octoprobe/testbed_tutorial/README.rst

Testbed `testbed_showcase`
==========================

`Documentation <http://www.octoprobe.org/testbed_showcase>`_
