octoprobe/testbed_tutorial/docs/testbed_showcase/40_specification/40_tentacles/index.rst

Tentacles
=========

:download:`Schematics </../schematics_kicad/schematics.pdf>`

.. toctree::
   :glob:
   :maxdepth: 2

   */*
