octoprobe/testbed_tutorial/docs/testbed_showcase/40_specification/40_tentacles/MCU_LOLIN_D1_MINI/index.rst

Tentacle `MCU_LOLIN_D1_MINI`
============================

Supported FUTs: FUT_EXTMOD_HARDWARE

v0.1 FUT_EXTMOD_HARDWARE

:download:`Schematics </../schematics_kicad/schematics.pdf>`



* `Pinout LOLIN_D1_MINI <https://www.wemos.cc/en/latest/_images/d1_mini_v4.0.0_5_16x9.png>`_
* `Datasheet ESP8266EX <https://www.espressif.com/sites/default/files/documentation/0a-esp8266ex_datasheet_en.pdf>`_

Pins assignements
-----------------

BOOTSEL is NOT required

====  =======  ========  ===================
CPU   Pin      signals   rationale
====  =======  ========  ===================
\     GND                GND
D1    5        RX        FUT_EXTMOD_HARDWARE
D2    4        TX        FUT_EXTMOD_HARDWARE
====  =======  ========  ===================
