octoprobe/testbed_tutorial/docs/testbed_showcase/40_specification/40_tentacles/DEVICE_potpourri/index.rst

Tentacle `DEVICE_POTPOURRY`
===========================

:download:`Schematics </../schematics_kicad/schematics.pdf>`

This tentacle comines many features, thus `potpourry`.

FUT implemented
---------------

* I2C

  The eeprom may be read and write.

* Onewire

  The MCU may read out the serial number of the two DS18b temperature sensors.

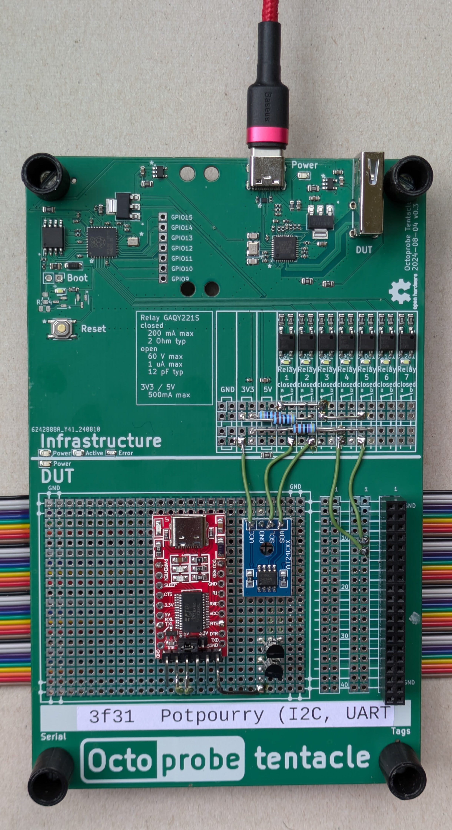
[picture p6: docs/testbed_showcase/40_specification/40_tentacles/DEVICE_potpourri/top_view.jpg]
