octoprobe/testbed_tutorial/docs/introduction/50_flightlevel_hardware.rst

Flightlevel: hardware
==============================================================================================

The hardware of `testbed_showcase` is described in :doc:`/testbed_showcase/index`.

.. rubric:: Block diagram

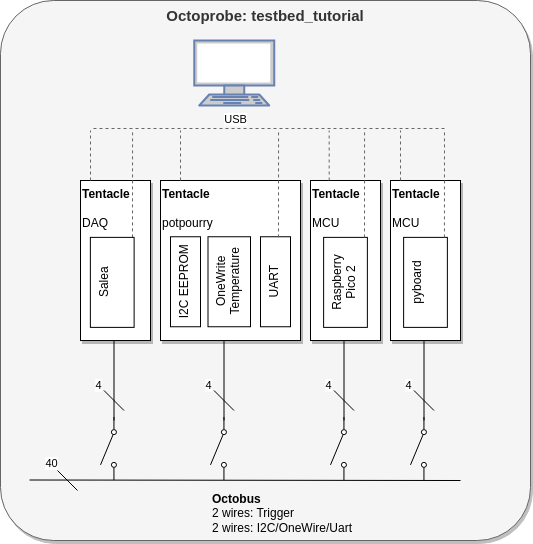
[picture p7: docs/testbed_showcase/20_designing_a_testbed/block_diagram.drawio.png]
