octoprobe/testbed_tutorial/docs/testbed_showcase/40_specification/20_tentacle-roles.rst

Tentacle roles
==============

The `TENTACLE_MCU` has to specify a processor and the intended firmware variants.

===========================  ==================================
Tentacle role                Comment 
===========================  ==================================
`TENTACLE_MCU`               A microprocessor tentacle 
`TENTACLE_DEVICE_POTPOURRY`  A tentacle with several devices 
`TENTACLE_DAQ_SALEAE`        Dataaquisition and error provoking 
===========================  ==================================
