octoprobe/testbed_tutorial/docs/installation/ubuntu.rst

Installation Ubuntu
===================

Target OS: Ubuntu Server 24.04.1 LTS.

To set up a Raspberry Pi 4/5, start with :doc:`/installation/raspberry`.

Installation: Users
-------------------

Octoprobe user: `octoprobe`
Github runner user: `githubrunner`

Do not forget to config git:

.. code::

    git config --global user.name "Hans Maerki"
    git config --global user.email "buhtig.hans.maerki@ergoinfo.ch"

Installation: APT
-----------------

.. code::

    sudo apt update \
      && sudo apt upgrade -y \
      && sudo apt install -y git uhubctl dfu-util \
        python-is-python3 python3.12-venv \
        docker.io docker-buildx

    sudo groupadd docker
    sudo usermod -aG docker $USER

On Raspbian: Skip python3.12-venv

## git clone testbed_tutorial

.. code::

    git clone https://github.com/octoprobe/testbed_tutorial.git

## python

.. code::

    echo 'source ~/venv_octoprobe/bin/activate' >> ~/.profile
    # Log out and in again
    python -m venv ~/venv_octoprobe

    source ~/venv_octoprobe/bin/activate
    pip install --upgrade -r ~/testbed_tutorial/requirements.txt -r ~/testbed_tutorial/requirements_dev.txt

## Software requiring root access

Will be used by mpremote and others

.. code::

    sudo usermod -a -G dialout $USER

APT

.. code::

    op install

Now `op install` will instruct you to:

.. code::

    sudo chown root:root ~/octoprobe_downloads/binaries/aarch64/*
    sudo chmod a+s ~/octoprobe_downloads/binaries/aarch64/*
    sudo cp -p ~/octoprobe_downloads/binaries/aarch64/* /usr/sbin

Run your first tests
--------------------

Add to :code:`~/.profile`:

.. code::

    export OCTOPROBE_TESTBED=testbed_ch_wetzikon_1.py

Verify if the tentacle serial numbers in above :code:`testbed_ch_wetzikon_1.py` match with the tentacle connected via USB.

Start the tests

.. code:: 

   cd ~/testbed_tutorial
   pytest --firmware-json=pytest_args_firmware_RPI_PICO2_v1.24.0.json tests/test_simple.py::test_i2c
