octoprobe/testbed_tutorial/docs/testbed_showcase/index.rst

Testbed `testbed_showcase`
==========================

.. toctree::
   :glob:
   :maxdepth: 2

   */**
