octoprobe/testbed_tutorial/docs/sandbox/experiment_autodoc.rst

Reference a function:

.. autofunction:: tests.conftest::setup_tentacles
    :no-index:

Reference a function. Do only describe some parameters:

.. autofunction:: tests.conftest::setup_tentacles(active_tentacles)
    :no-index:

Reference to a class

.. autoclass:: testbed.util_firmware_mpbuild::CachedGitRepo()
    :no-index:

Reference to a method

.. automethod:: testbed.util_firmware_mpbuild::build_firmware()
    :no-index:

Reference to a property

.. autoproperty:: octoprobe.util_dut_programmers::FirmwareDownloadSpec.filename()
    :no-index:
