octoprobe/testbed_tutorial/docs/sandbox/experiment_section_1.rst

.. Restructured text comment: IGNORE_SECTION_CHECK

Flightlevel: github
===================

SubSection A
----------------------------------------------------------------------------------------------

SubSubSection A
^^^^^^^^^^^^^^^^^^^^^^^^

Blabla

SubSection B
----------------------------------------------------------------------------------------------

Blabla

SubSubSubSection B1
~~~~~~~~~~~~~~~~~~~~~~~~~~~~~~~~~~~~~~~~~~~~~~~~~~~~~~~~~~~~~~~~~~~~

.. note::

   SubSubSubSection B1

   has been swallowed as ``SubSubSubSection``

SubSubSection B2
^^^^^^^^^^^^^^^^^^^^^^^^^^^^^^^^^

SubSubSubSection B2
~~~~~~~~~~~~~~~~~~~~~~~~~~~~~~~~~~~~~~~~~~~~~~~~~~~~~~~~~~~~~~~~~~~~

.. note::

   SubSubSubSection B2

   has been swallowed!!!

Blabla

SubSection C
----------------------------------------------------------------------------------------------

Blabla C

SubSubSubSection C3
~~~~~~~~~~~~~~~~~~~~~~~~~~~~~~~~~~~~~~~~~~~~~~~~~~~~~~~~~~~~~~~~~~~~

.. note::

   SubSubSubSection: C3

   has been swallowed!!!

Blabla C3

SubSection D
----------------------------------------------------------------------------------------------

Blabla D

.. note::

   SubSubSubSection: X
