octoprobe/testbed_tutorial/docs/sandbox/experiment_section_3.rst

.. Restructured text comment: IGNORE_SECTION_CHECK

Flightlevel: github
===================

Blabla A

Paragraph B
""""""""""""""""""""""""""""""

Blabla B

SubSection C
----------------------------------------------------------------------------------------------

Blabla C

SubSection D
----------------------------------------------------------------------------------------------

.. note::

   The ``Paragraph """""`` just after the section title will wrongly indent the following SubSections!!!

   This error is NOT reported by sphinx!!!
