octoprobe/testbed_tutorial/docs/testbed_showcase/20_designing_a_testbed/index.rst

Design decisions
================

Every testbed requires a unique name. This here is called `testbed_showcase`.

.. note::
  
  Other testbed could be:

  * `testbed_modbus`: Modbus RTU is very time critical, specially timeouts/retires. This testbed could test these timing aspects, specially in error and race condition.
  * `testbed_I2C_multicontroller`: In multicontroller (multimaster) mode many special situations an race condition may occur. This testbed could provide the hardware to create error conditions like shortening the bus. It may be tested if and how the software recovers from these errors.
  * ...

`testbed_showcase` is designed to demonstrates the various aspects of octoprobe. But also allows to write/run meaningful tests.

.. rubric:: Block diagram



.. rubric:: Testing the pico firmware agains I2C and capture with DAQ

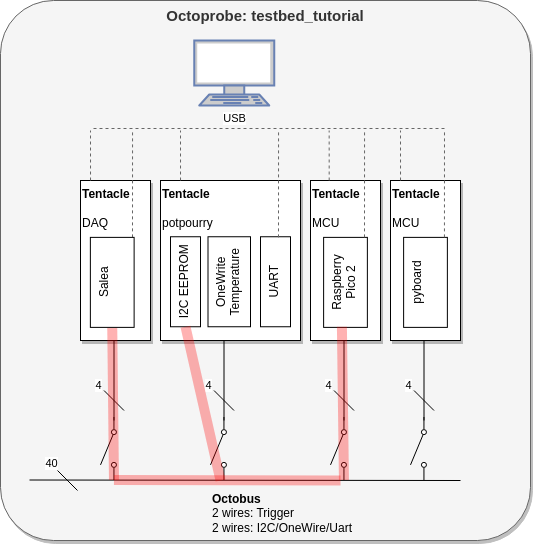
[picture p10: docs/testbed_showcase/20_designing_a_testbed/block_diagram_pico.drawio.png]


.. rubric:: Testing the pyboard firmware agains I2C and capture with DAQ

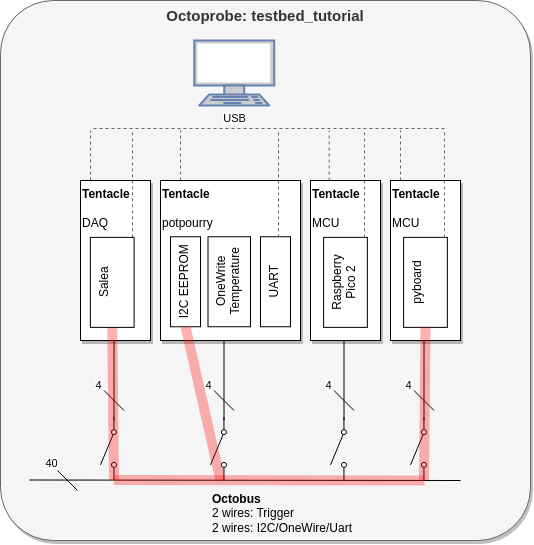
[picture p11: docs/testbed_showcase/20_designing_a_testbed/block_diagram_pyboard.drawio.png]


.. rubric:: Every testbed must specify:

Signals
  See :doc:`/testbed_showcase/40_specification/10_octobus-signals`

Tentacle Roles
  See :doc:`/testbed_showcase/40_specification/20_tentacle-roles`

FUTs (*FUT*: Feature Under Test)
  See :doc:`/testbed_showcase/40_specification/30_feature-under-test`
