octoprobe/testbed_tutorial/docs/showcase/30_run_micropython_tests/index.rst

Run tests from micropython repo
===============================

The micropython repo contains tests which run against hardware: https://github.com/micropython/micropython/blob/master/tests/run-tests.py

These tests may be run as part of a pytest. The source is here:

.. autofunction:: tests.tests_github_micropython_org.test_github_micropython_org::test_perf_bench
  :no-index:
