octoprobe/testbed_tutorial/docs/showcase/50_debugging_tests/index.rst

Debugging tests
===============

.. toctree::
   :glob:
   :maxdepth: 2

   */*
