octoprobe/testbed_tutorial/schematics_kicad/schematics.pdf

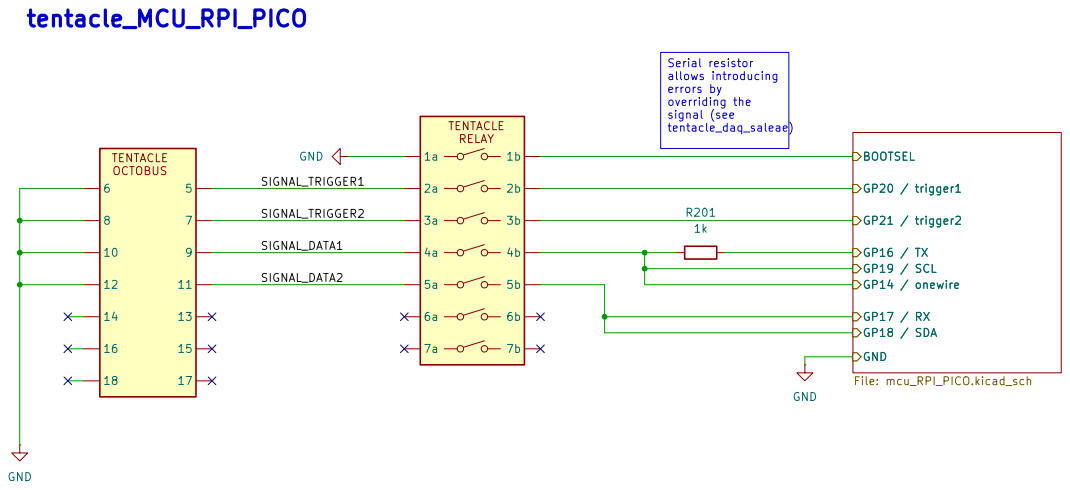
[picture p13: page 1]

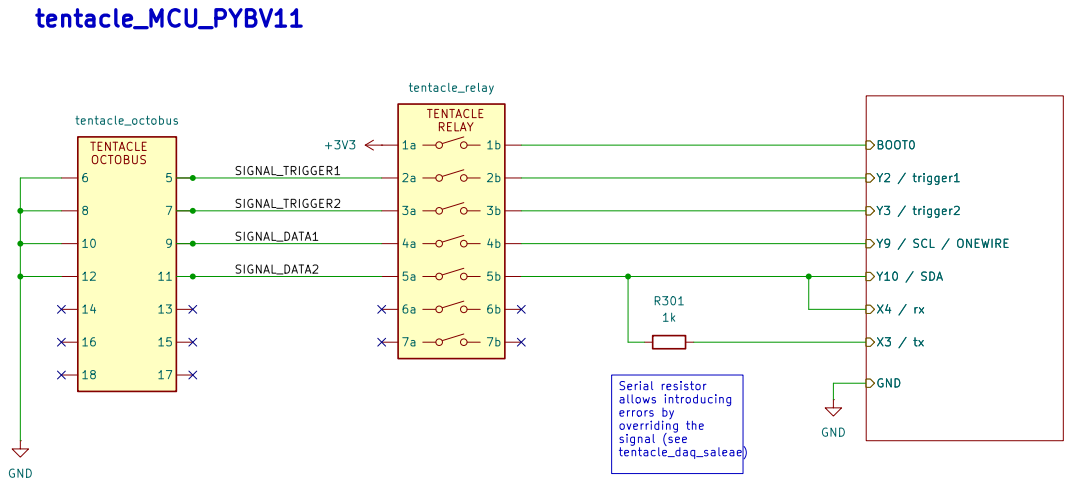
[picture p14: page 2]

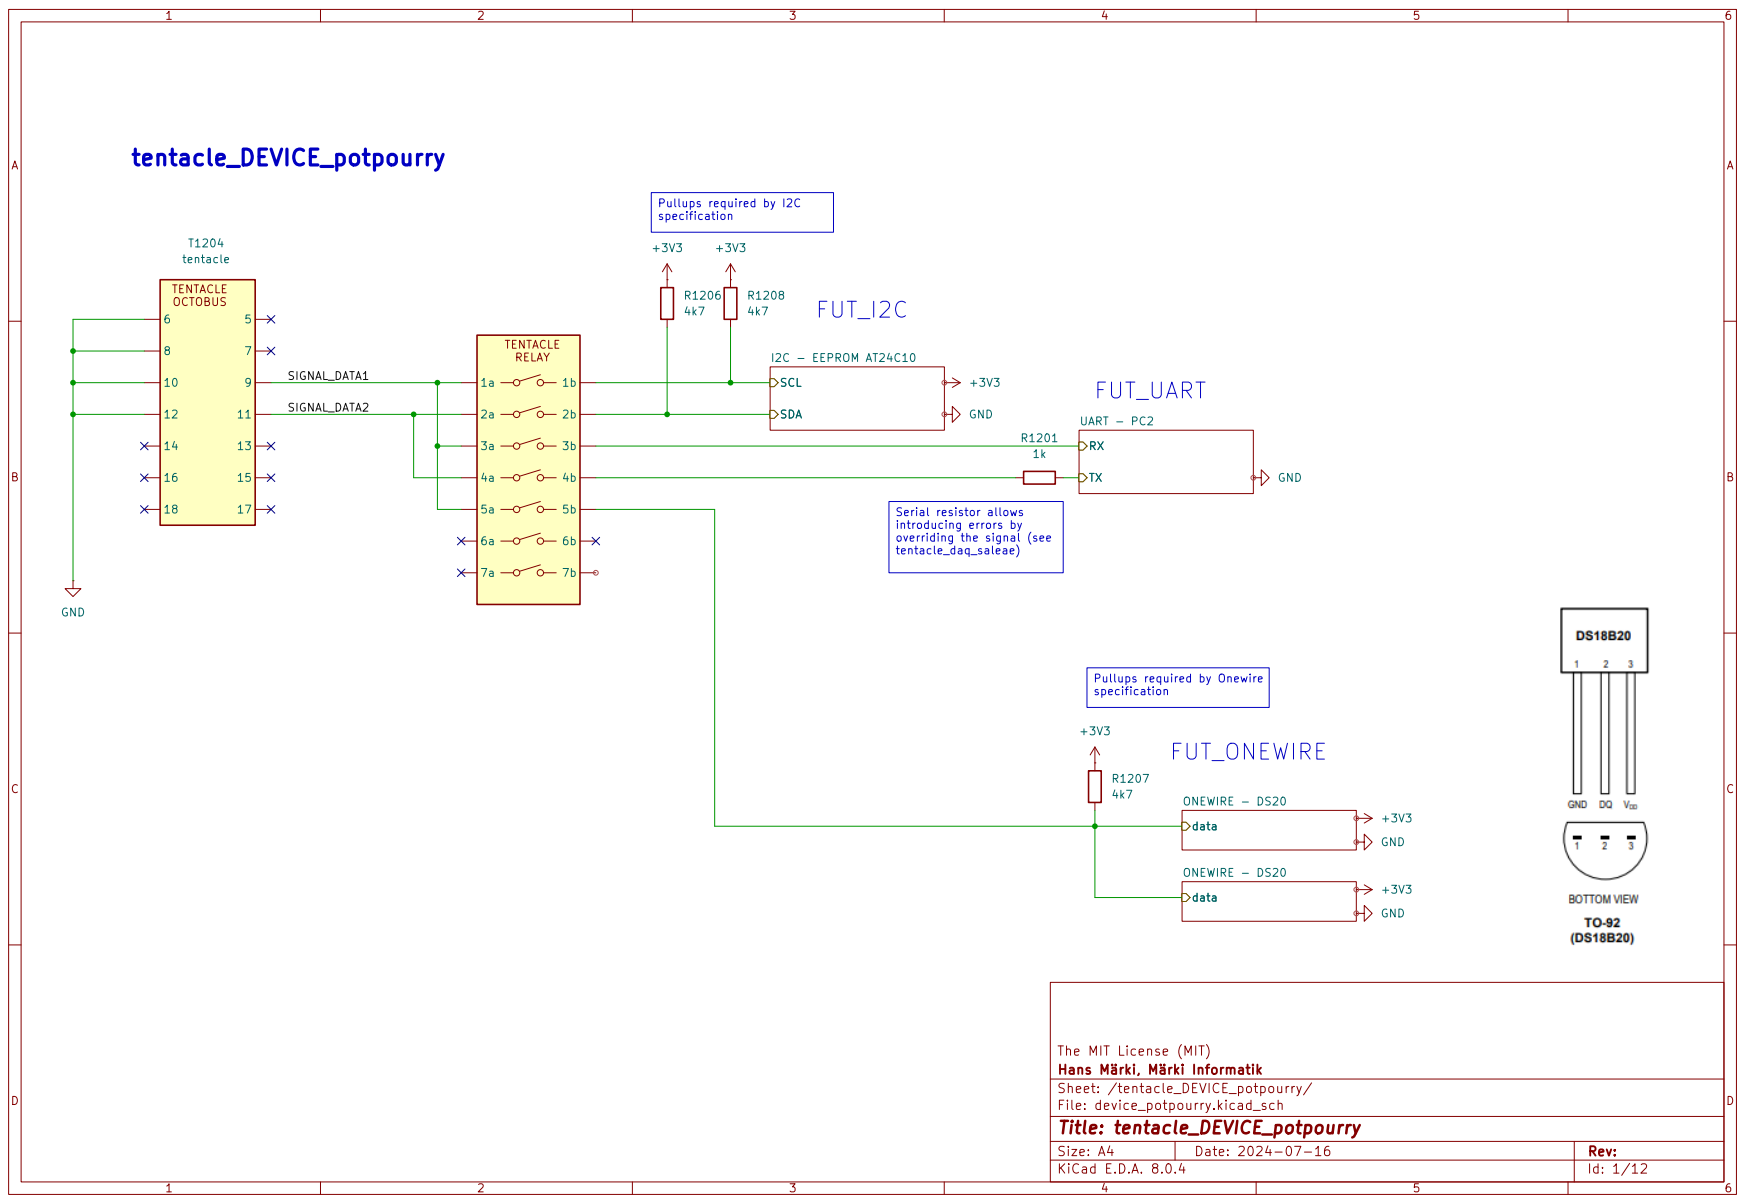
[picture p15: page 3]

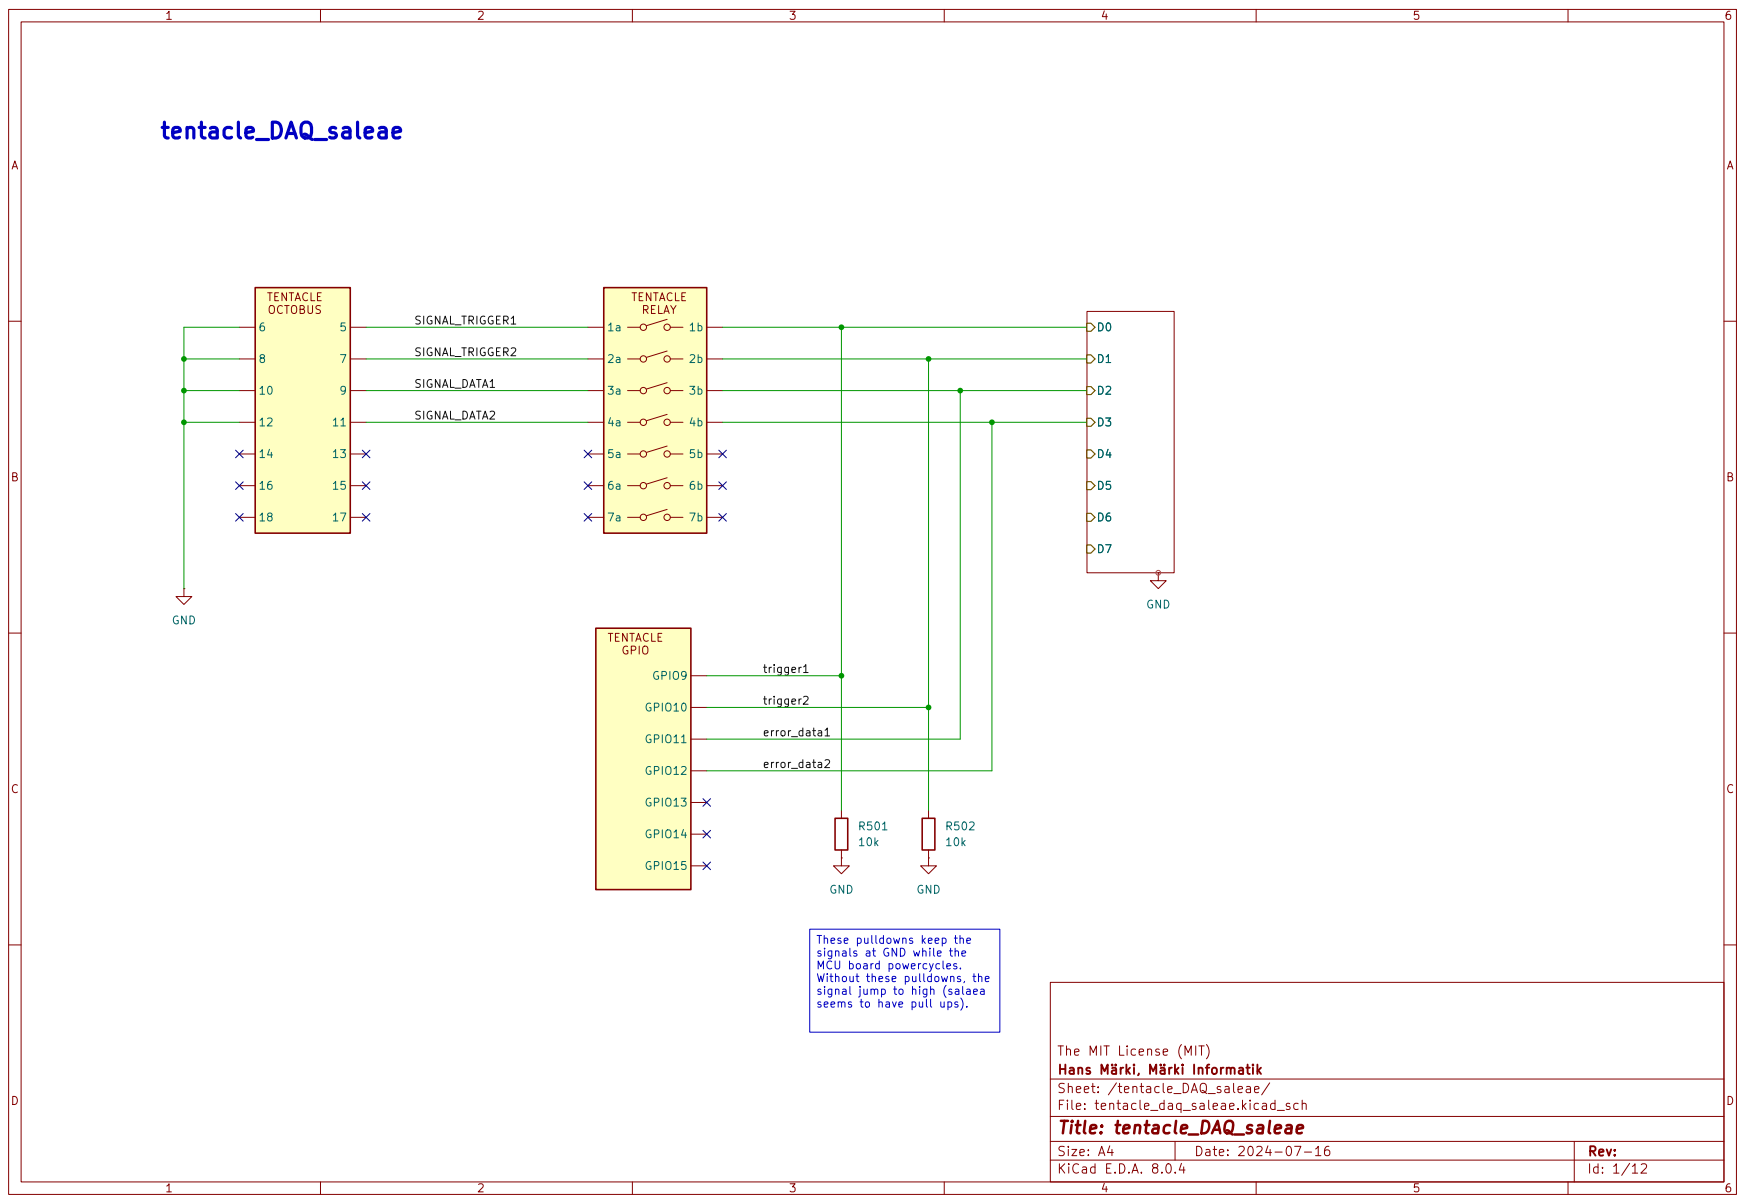
[picture p16: page 4]
