octoprobe/testbed_tutorial/schematics_kicad/kicad/testbed.kicad_pcb

## KiCad design Weather_station_schematic/Weather_station_inside_module/Weather_station_inside_module.kicad_sch

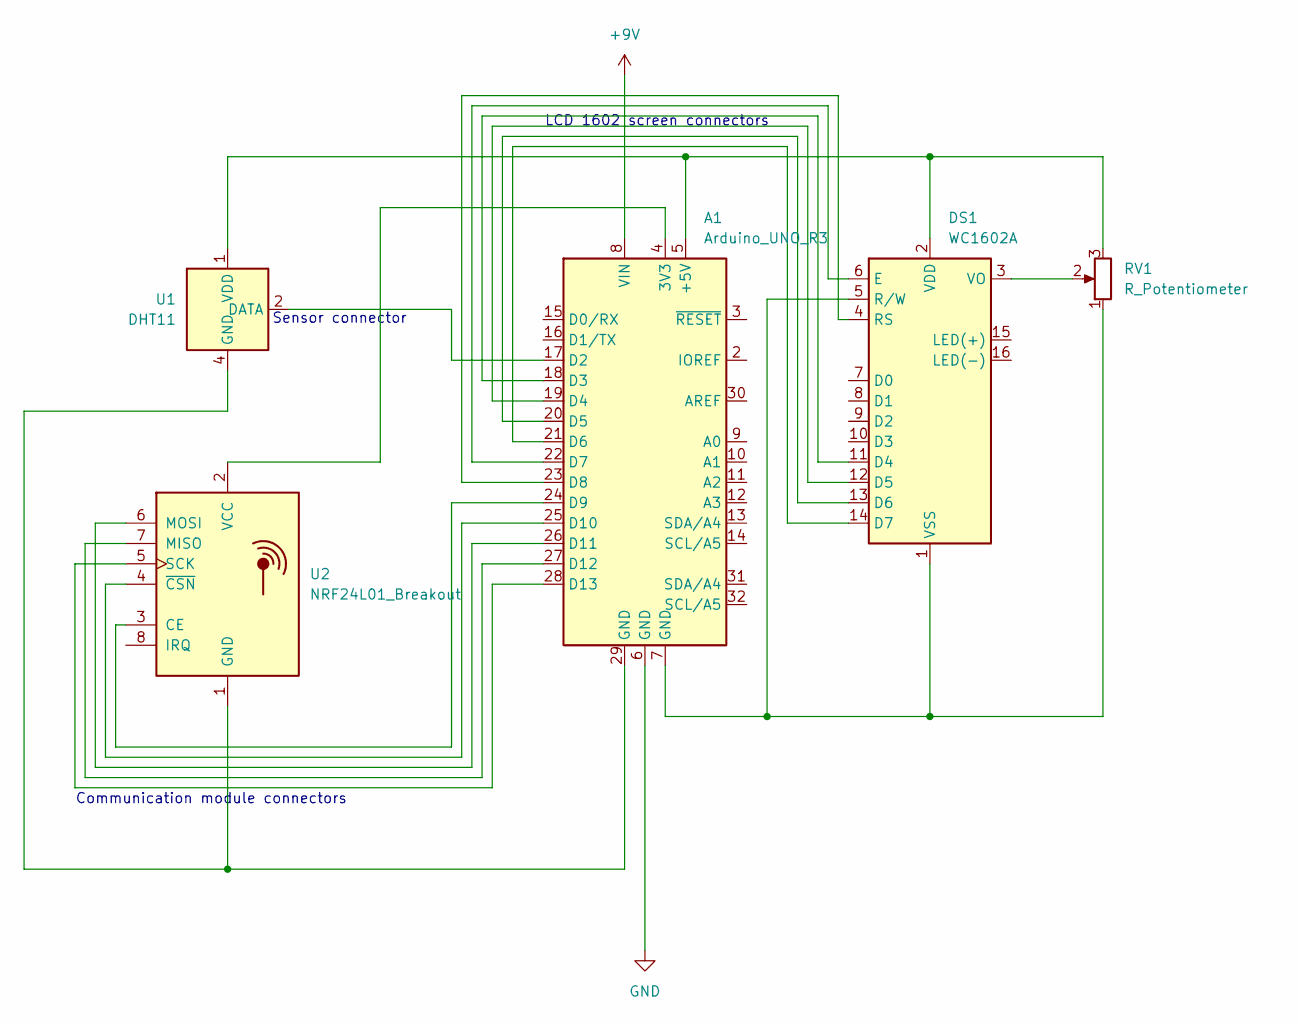
[picture p17: schematic Weather_station_inside_module.kicad_sch]

Parts:
A1: Arduino_UNO_R3
DS1: WC1602A
RV1: R_Potentiometer
U1: DHT11; Aosong_DHT11_5.5x12.0_P2.54mm
U2: NRF24L01_Breakout; nRF24L01_Breakout

Connections:
+9V: A1.8 (VIN)
GND: A1.6 (GND)
unnamed: A1.4 (3V3), U2.2 (VCC)
unnamed: A1.5 (+5V), DS1.2 (VDD), RV1.3, U1.1 (VDD)
unnamed: A1.7 (GND), DS1.1 (VSS), DS1.5 (R/W), RV1.1
unnamed: A1.17 (D2), U1.2 (DATA)
unnamed: A1.18 (D3), DS1.11 (D4)
unnamed: A1.19 (D4), DS1.12 (D5)
unnamed: A1.20 (D5), DS1.13 (D6)
unnamed: A1.21 (D6), DS1.14 (D7)
unnamed: A1.22 (D7), DS1.6 (E)
unnamed: A1.23 (D8), DS1.4 (RS)
unnamed: A1.24 (D9), U2.3 (CE)
unnamed: A1.25 (D10), U2.4 (~CSN)
unnamed: A1.26 (D11), U2.6 (MOSI)
unnamed: A1.27 (D12), U2.7 (MISO)
unnamed: A1.28 (D13), U2.5 (SCK)
unnamed: A1.29 (GND), U1.4 (GND), U2.1 (GND)
unnamed: DS1.3 (VO), RV1.2

Notes on the sheet:
LCD 1602 screen connectors
Communication module connectors
Sensor connector
