octoprobe/testbed_tutorial/schematics_kicad/kicad/testbed.kicad_pcb

## KiCad design Weather_station_schematic/Weather_station_outside_module/Weather_station_outside_module.kicad_sch

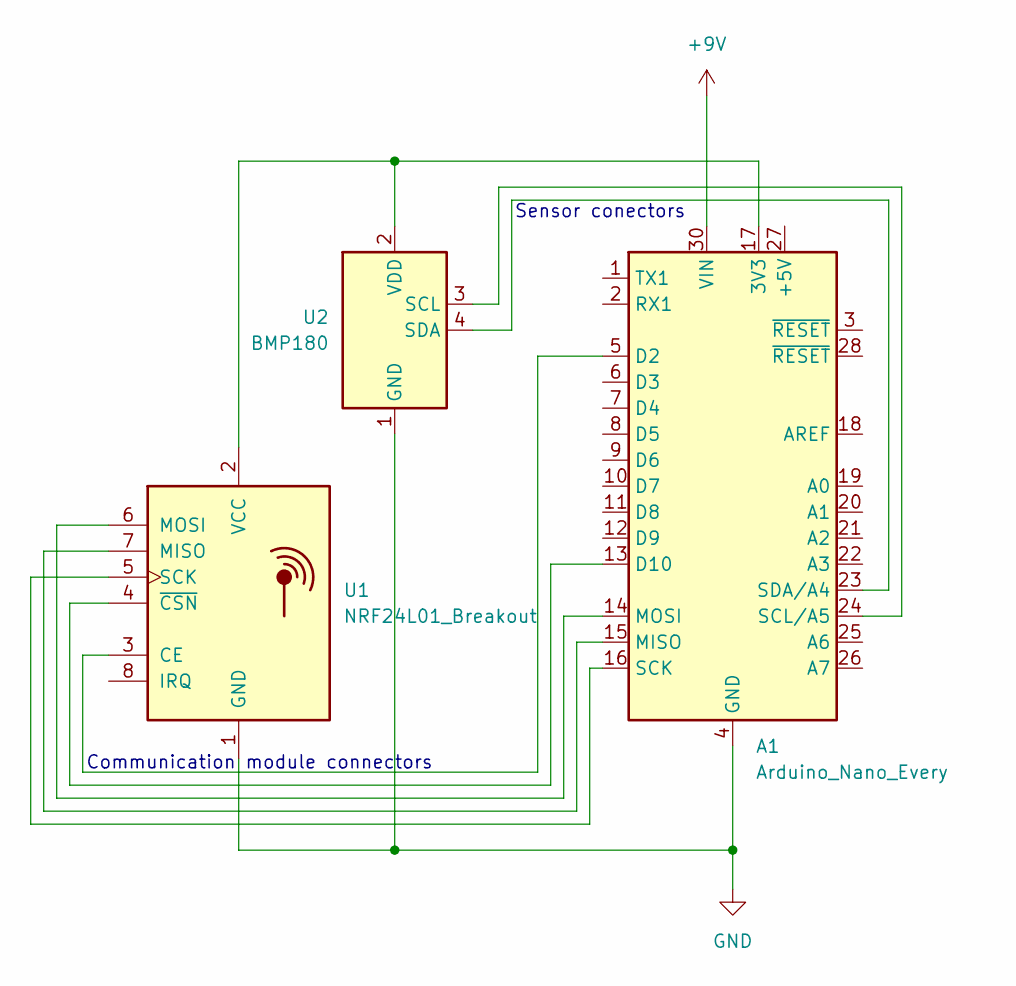
[picture p18: schematic Weather_station_outside_module.kicad_sch]

Parts:
A1: Arduino_Nano_Every; Arduino_Nano
U1: NRF24L01_Breakout; nRF24L01_Breakout
U2: BMP180; TE_MS5837-xxBA

Connections:
+9V: A1.30 (VIN)
GND: A1.4 (GND), A1.29 (GND), U1.1 (GND), U2.1 (GND)
unnamed: A1.5 (D2), U1.3 (CE)
unnamed: A1.13 (D10), U1.4 (~CSN)
unnamed: A1.14 (MOSI), U1.6 (MOSI)
unnamed: A1.15 (MISO), U1.7 (MISO)
unnamed: A1.16 (SCK), U1.5 (SCK)
unnamed: A1.17 (3V3), U1.2 (VCC), U2.2 (VDD)
unnamed: A1.23 (SDA/A4), U2.4 (SDA)
unnamed: A1.24 (SCL/A5), U2.3 (SCL)

Notes on the sheet:
Communication module connectors
Sensor conectors
