octoprobe/testbed_tutorial/doc/schematics_kicad/kicad/tenacle_MCU_grobotics_pyboard.kicad_sch

## KiCad design doc/schematics_kicad/kicad/tenacle_MCU_grobotics_pyboard.kicad_sch (2024-08-20)

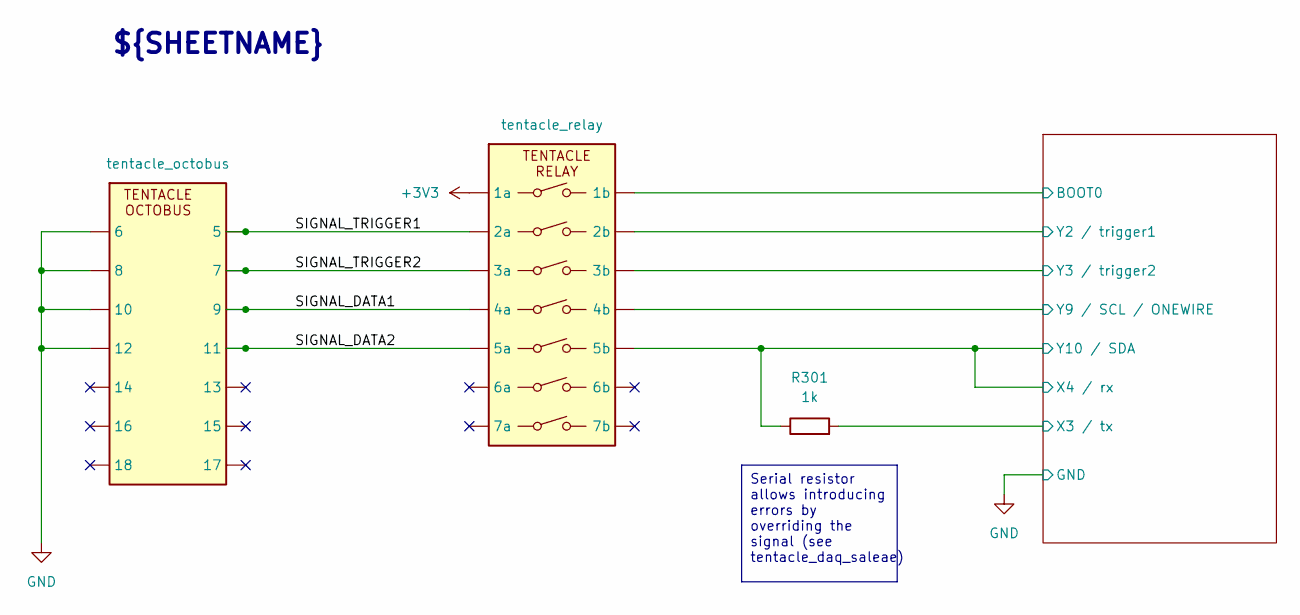
[picture p19: schematic tenacle_MCU_grobotics_pyboard.kicad_sch]

Parts:
R301: 1k
T301: tentacle_octobus
T302: tentacle_relay

Connections:
+3V3: T302.
BOOT0: T302.
GND: T301.6, T301.8, T301.10, T301.12
SIGNAL_DATA1: T301.9, T302.
SIGNAL_DATA2: T301.11, T302.
SIGNAL_TRIGGER1: T301.5, T302.
SIGNAL_TRIGGER2: T301.7, T302.
X3 / tx: R301.2
X4 / rx: R301.1, T302.
Y2 / trigger1: T302.
Y3 / trigger2: T302.
Y9 / SCL / ONEWIRE: T302.

Notes on the sheet:
Serial resistor allows introducing errors by overriding the signal (see tentacle_daq_saleae)
${SHEETNAME}
