octoprobe/testbed_tutorial/doc/schematics_kicad/kicad/tenacle_MCU_raspberry_pico.kicad_sch

## KiCad design doc/schematics_kicad/kicad/tenacle_MCU_raspberry_pico.kicad_sch (2024-08-20)

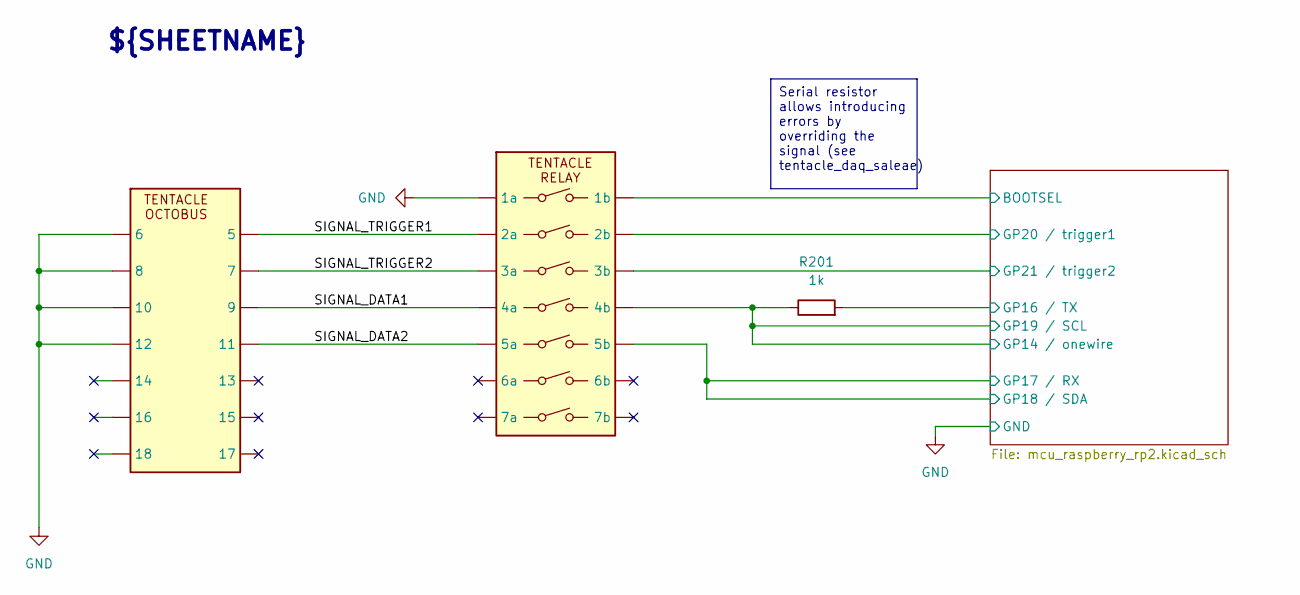
[picture p20: schematic tenacle_MCU_raspberry_pico.kicad_sch]

Parts:
R201: 1k
T201: tentacle_octobus
T202: tentacle_relay

Connections:
BOOTSEL: T202.
GND: T201.6, T201.8, T201.10, T201.12, T202.
GP14 / onewire: R201.1, T202.
GP16 / TX: R201.2
GP17 / RX: T202.
GP20 / trigger1: T202.
GP21 / trigger2: T202.
SIGNAL_DATA1: T201.9, T202.
SIGNAL_DATA2: T201.11, T202.
SIGNAL_TRIGGER1: T201.5, T202.
SIGNAL_TRIGGER2: T201.7, T202.

Notes on the sheet:
Serial resistor allows introducing errors by overriding the signal (see tentacle_daq_saleae)
${SHEETNAME}
