octoprobe/testbed_tutorial/(commit log)

2024-08-17 Copied from github.com/hmaerki/experiment_microoctopus
    [device_potpourry.kicad_sch, device_potpourry_daq.kicad_sch, device_potpourry_i2c.kicad_sch, device_potpourry_onewire.kicad_sch, device_potpourry_uart.kicad_sch, infrastructure.kicad_pcb, infrastructure.kicad_sch, mcu_pyboard.kicad_sch]
2024-08-20 tentacle v0.3
    [device_potpourry.kicad_sch, stickers.ods, tenacle_MCU_grobotics_pyboard.kicad_sch, tenacle_MCU_raspberry_pico.kicad_sch, tentacle_daq_saleae.kicad_sch, testbed.kicad_pcb, testbed.kicad_sch]
2024-09-11 MCU names as in micropython-git
    [device_potpourry.kicad_sch, mcu_PYBV11.kicad_sch, mcu_RPI_PICO.kicad_sch, stickers.ods, tenacle_MCU_PYBV11.kicad_sch, tenacle_MCU_RPI_PICO.kicad_sch, tentacle_daq_saleae.kicad_sch, testbed.kicad_sch]
2024-09-13 First integration of sphinx
    [device_potpourry.kicad_sch, device_potpourry_daq.kicad_sch, device_potpourry_i2c.kicad_sch, device_potpourry_onewire.kicad_sch, device_potpourry_uart.kicad_sch, mcu_PYBV11.kicad_sch, mcu_RPI_PICO.kicad_sch, stickers.ods]
2024-09-18 Prepared testbeds for melbourne/greenliff
    [stickers.ods]
2024-09-26 Restructuring sphinx TOC
    [device_potpourry.kicad_sch, device_potpourry_daq.kicad_sch, device_potpourry_i2c.kicad_sch, device_potpourry_onewire.kicad_sch, device_potpourry_uart.kicad_sch, mcu_PYBV11.kicad_sch, mcu_RPI_PICO.kicad_sch, tenacle_MCU_PYBV11.kicad_sch]
2024-12-01 FUT_UART_LOOPBACK: LOLIN_D1_MINI, LOLIN_C3_MINI
    [mcu_RPI_PICO.kicad_sch, tenacle_MCU_RPI_PICO.kicad_sch]
2024-12-03 Lolin_D1/C3: wireint to allow use of DAQ. Kicad Schematics updated
    [mcu_LOLIN_C3_MINI.kicad_sch, mcu_LOLIN_D1_MINI.kicad_sch, tenacle_MCU_LOLIN_C3_MINI.kicad_sch, tenacle_MCU_LOLIN_D1_MINI.kicad_sch, testbed.kicad_sch]
2024-12-04 Update hwversion v1.0->1.1 MCU_RPI_PICO
    [tenacle_MCU_RPI_PICO.kicad_sch]
