octoprobe/testbed_tutorial/(notices)

Notices in the files:
doc/schematics_kicad/kicad/tenacle_MCU_grobotics_pyboard.kicad_sch:
The MIT License (MIT)
